laxyy1/diy/deliverables/DIYWOODPLANNER_Alderline_X4/output/DIYWOODPLANNER_Alderline_X4.pdf

DIYWOODPLANNER | ALDERLINE X4 / P1

WORKSHOP COLLECTION / 01

# Alderline X4

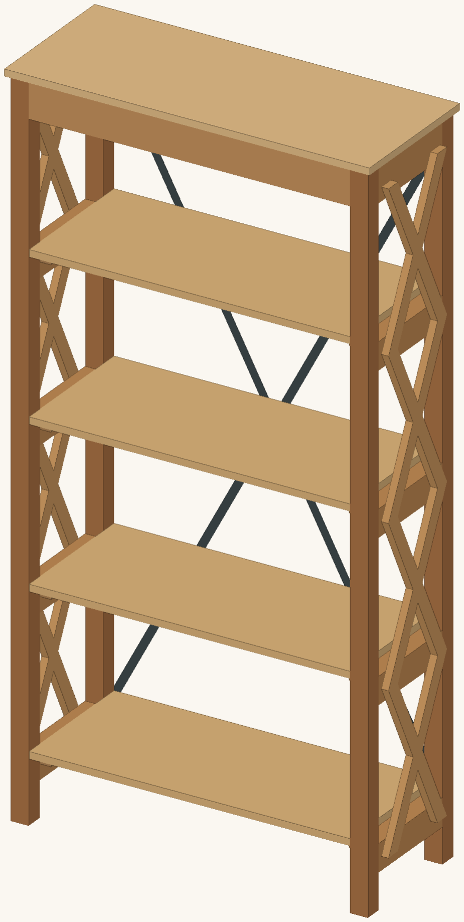
[picture p1: figure]

P1 PROTOTYPE REVIEW • Metric dimensions control • Not a load rating | 01

## FOUR-SHELF X-FRAME BOOKSHELF

Warm timber. Open storage. A measured build.

THE PROJECT

Four shelves + separate
top

936 W × 370 D × 1800 H
mm maximum

Intermediate skill

Dowel joinery + half laps

Two-person final assembly

An original plan inspired by the visible post, shelf and side-X structure in the supplied reference images. Dimensions, connections, rear bracing and page design are newly developed.

BUILD A PROTOTYPE BEFORE RELEASE

Geometry checked; physical performance untested. This plan establishes no safe working load.

01 / DESIGN DEFINITION

# Know the envelope

All dimensions are millimetres. Illustrations are not full-size templates unless specifically identified.

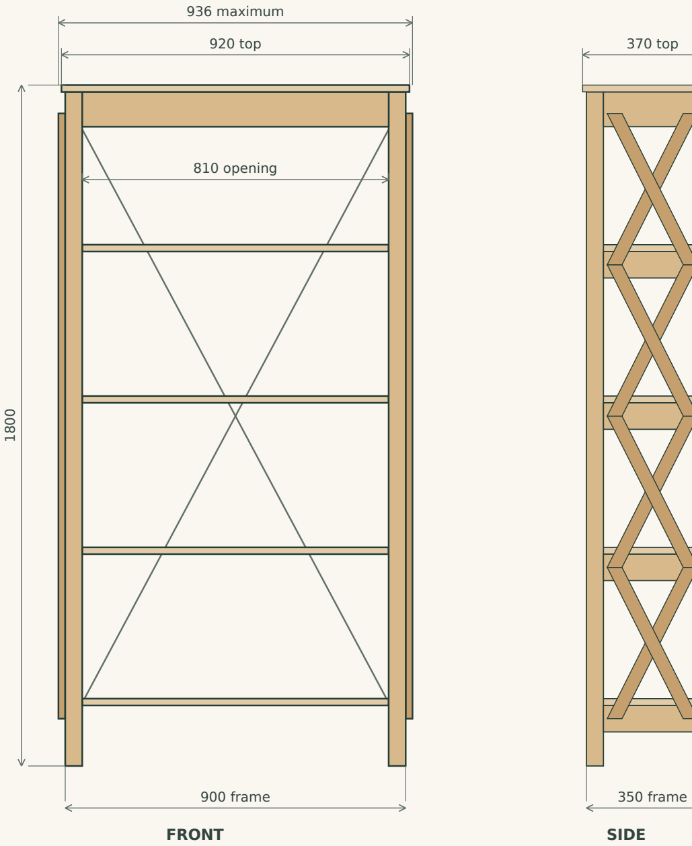
[picture p2: figure]
920 top; 936 maximum; 900 frame; 810 opening; 370 top; 350 frame; FRONT; SIDE
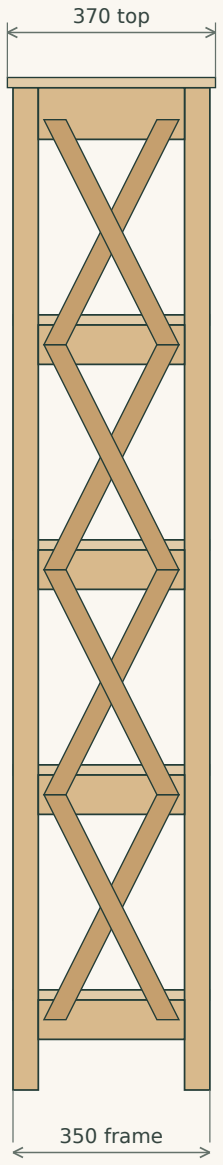
[picture p3: figure]

P1 PROTOTYPE REVIEW • Metric dimensions control • Not a load rating | 02

Maximum width is 936: the side X slats project 18 beyond each frame edge. The top is 920 × 370; the frame is 900 × 350. Nominal height excludes foot pads and wall restraints.

Shelf tops: 178 / 578 / 978 / 1378 above floor. Clear space between shelves: 382. Upper front opening: 312 below apron. Shelf undersides: 160 / 560 / 960 / 1360.

02 / CUTTING & PURCHASING

# Every part, accounted for

Finished sizes: thickness × width × length. Measure actual stock before cutting; nominal lumber names do not control.

P1 PROTOTYPE REVIEW • Metric dimensions control • Not a load rating | 03
ID | PART | QTY | FINISHED SIZE / mm
A | Posts | 4 | 45 × 45 × 1782
B | Shelf side rails | 8 | 45 × 70 × 260
C | Upper side rails | 2 | 45 × 92 × 260
D | Shelf panels | 4 | 18 × 348 × 809
E | Top panel | 1 | 18 × 370 × 920
F | Front/rear top aprons | 2 | 18 × 92 × 810
G | Shelf support cleats | 8 | 30 × 30 × 260
H | X slats | 16 | 18 × 35 × 447.6
J | Rear steel straps | 2 | 1 × 20 × 1864.1

H length 447.6 is measured along either long edge between parallel end cuts. It is not the rough blank length. Prepare sixteen 490 mm blanks; keep eight of each complementary lap hand. J length is a fabrication target; drill to the measured end-hole pitch.

PURCHASE BASIS

4 hardwood blanks 45 × 45 × 2400 for A; 2 boards 45 × at least 92 × 2400 for B/C (rip eight rails to 70); 1 board 30 × 30 × 2400 for G; 4 boards 18 × 35 × 2400 for H. Add defect allowance beyond this minimum.

1 sheet cabinet plywood, 2440 × 1220 × 18, for D/E/F. Require sound void-free bearing edges and verified actual thickness. Use exposed, sanded and sealed edges; no edge band thickness is included.

STOCK & CUTTING ALLOWANCE

Layouts allow 3 mm kerfs and at least 10 mm end trim. Choose straight, dry stock; allow more material for knots and tear-out.

03 / HARDWARE & TOOLS

# Connections with a purpose

Quantities below are installed quantities. Buy spare screws and dowels. Choose compatible heads, pilot sizes and corrosion protection.

P1 PROTOTYPE REVIEW • Metric dimensions control • Not a load rating | 04
ID | HARDWARE | QTY
K1 | Fluted hardwood dowels, 8 x 50 mm | 40
K2 | Fluted hardwood dowels, 6 x 40 mm | 8
K3 | Wood screws, 5 x 60 mm | 24
K4 | Wood screws, 4 x 40 mm | 16
K5 | Wood screws, 4 x 45 mm | 32
K6 | Pan-head wood screws, 5 x 35 mm | 4
K7 | Steel washers, 1 mm thick, 5.5 mm bore | 2
K8 | 25 x 25 x 20 mm steel angle, one hole/wing | 4
K9 | Wood screws, 4 x 16 mm | 8
K10 | Commercial furniture-to-wall restraint kit | 2
K11 | Non-slip foot pads, matching thickness | 4

K8 angles must have one hole in each wing; 2 mm steel thickness is assumed for K9 embed. Verify the actual fitting before purchase. K10 wall and furniture fixings follow the chosen manufacturer; no universal anchor or screw capacity is specified.

JOINT ALLOCATION

B/C to A: K1 + wood adhesive. F to A: K2 + adhesive. G to B: K3, three per cleat. D to G: K4, four per shelf. H to B/C: K5, one at each slat end; glue only the fitted lap. J to A: K6 and K7 at J-2 ends. E to F: K8/K9. K11: one per foot.

PREPARE THE BENCH

Saw with repeatable angle stop; router and depth control; matched dowel jig and brad-point bits; drill stops, countersink, clamps, square, tape, straightedge, stud detector and appropriate steel drilling/deburring tools. Also wood adhesive, abrasives 120/180/220, finish, eye/hearing protection and dust extraction.

04 / LAYOUT & DRILLING

# Make the joints repeatable

Required stock: actual 45 mm posts/rails and 18 mm panels/slats. Re-parameterize and regenerate if your stock differs.

P1 PROTOTYPE REVIEW • Metric dimensions control • Not a load rating | 05

SIDE RAIL JOINT / 8 mm

110 / 140

510 / 540

910 / 940

1310 / 1340

1710 / 1762

APRON JOINT / 6 mm

1710 / 1762

A post side bores: centred 22.5 across the 45 mm face, drilled into the front/rear post faces facing the side rails. A apron bores: 9 from the front or rear outside edge, drilled from the faces facing across the 810 opening.

Label A-LF, A-LR, A-RF, A-RR (left/right and front/rear, viewed from front). Mirror the drilling, not the height datums. Reference every height from the same finished foot end.

BORE SCHEDULE

B: two Ø8 end bores, thickness centre 22.5; 20 and 50 above rail bottom. C: same centre; 20 and 72 above bottom. Drill 26 deep in both rail and post for 25 embed each. F: two Ø6 end bores, 9 through thickness; 20 and 72 above bottom. Drill 21 deep in apron and post for 20 embed each.

Dry-fit one complete joint on scrap first. Use stop collars; clear chips and glue squeeze-out. Target bore centres ±0.25 mm; do not force mismatched dowels or drill through a post.

05 / X-SLAT FABRICATION
One bay. Eight repeated Xs.

H is a flat 18 × 35 slat. Make eight rising and eight falling members with complementary 9 mm laps.

P1 PROTOTYPE REVIEW • Metric dimensions control • Not a load rating | 06

240 overall

400 end-plane spacing

PARALLEL END CUTS / 26.66° OFF SQUARE

Finished length on either long edge: 447.59. End cut projects 39.16 horizontally. Start with 490 blanks; the minimum projected blank length is 465.16. Make a full-size scrap bay jig with end planes 400 apart and outer edges 240 apart. Saw settings are nominal: confirm the jig fit before batch cutting.

LAP SECTION / schematic

9 deep from opposite faces

Mark the true overlap by crossing two slats in the jig. Remove the intersection rhombus, not a square notch. Preserve the 35 mm width.

Centre each lap at the bay centre: y = 175, z = 325 for the first bay. The rhombus is 43.64 along either long edge; its two boundaries run parallel to the mating slat edges. Rout/saw waste in stages to a flat 9.0 depth. Use the 1:1 DXF/SVG outline to verify the marked shape; test print scale before use.

FIT WITHOUT FORCE

Assembled lap thickness must equal 18. Test on scrap; target flush faces within 0.2 mm. Do not thin both members until the joint becomes loose.

06 / ASSEMBLY 1

# Build two side frames

Parts A ×4, B ×8, C ×2. K1 ×40. Assemble on a flat bench with cauls and matched spacers.

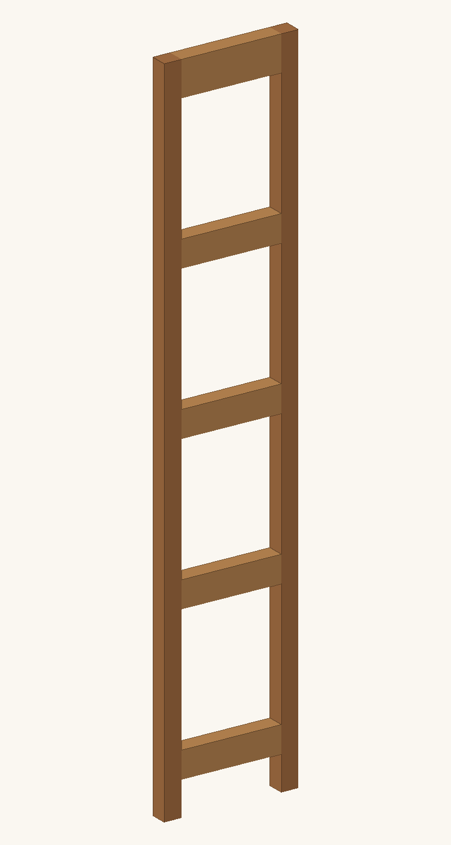
[picture p4: figure]

P1 PROTOTYPE REVIEW • Metric dimensions control • Not a load rating | 07

### 1 Label and dry-fit

Use the post identities from page 5. Rail bottoms are 90, 490, 890 and 1290 above each foot. Upper rail C starts at 1690. Keep all outer side faces flush.

### 2 Glue one side

Spread adhesive on the dowels and bore walls to the adhesive maker’s guidance. Seat B/C between the front and rear posts. Clamp gently across the 350 frame depth; protect the posts with cauls.

### 3 Square before cure

Check the outside post rectangle: 350 wide × 1782 high. Equal opposite diagonals are approximately 1816.0. Check straightness and twist, then recheck all five rail elevations.

### 4 Repeat as a matched pair

Build the second side on the same spacer setup. Match front-to-front post lengths and each rail level. Allow the specified full clamp/cure time before handling.

SIDE FRAME DATUMS: A foot = 0. B bottoms = 90 / 490 / 890 / 1290. B tops = 160 / 560 / 960 / 1360. C = 1690–1782. Rail length = 260 between post faces. Finished side depth = 350.

CHECKPOINT

Both frames must sit flat with matching rail heights. An out-of-square frame is corrected now, before adding X slats.

07 / ASSEMBLY 2

# Add the Xs and shelf cleats

Parts H ×16, G ×8. K5 ×32 and K3 ×24. Outer X slats attach to the side rail faces; cleats attach inside.

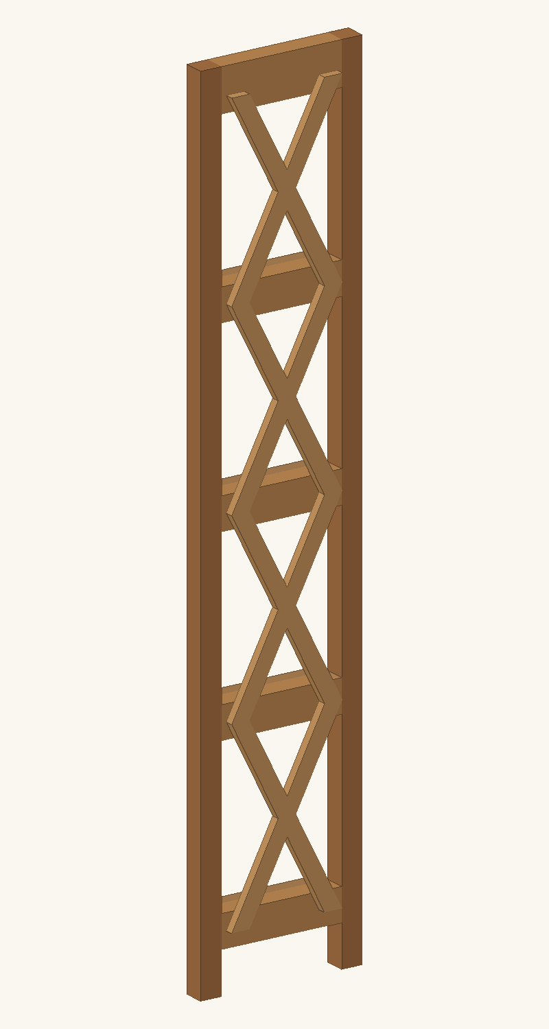
[picture p5: figure]

P1 PROTOTYPE REVIEW • Metric dimensions control • Not a load rating | 08

### 5 Seat the repeated Xs

End planes are 125/525/925/1325/1725 above the feet. Slat outer depth edges are y = 55 and
295. Glue the fitted lap; clamp it flush. Both slats sit directly on the outer rail faces.

### 6 Fasten each slat end

At each end, place one K5 screw on the slat centreline, 20 vertically in from the end plane. In the first rising slat the centres are (y,z) = (84.62,145) and (265.38,505); mirror for the falling slat. Repeat every 400 in height.

### 7 Fix the inner cleats

G tops align with B tops. Left cleats occupy x = 45–75; right = 825–855; both y = 45–305. Drive three K3 through each cleat into B at y = 110/175/240 and 15 below its top.

Drill screw clearance through the attached part and species-appropriate pilots into the receiving timber. Countersink wood heads only to flush; do not bury heads. Clamp before driving. Confirm screw lengths on a scrap joint.

SCREW CLEARANCE MATTERS

Keep the cleat screw positions shown. Moving them to the X end-screw lines can make opposing screws collide inside the rail.

08 / ASSEMBLY 3

# Connect the two sides

Parts F ×2 and K2 ×8. Use a helper and a flat, level surface; protect the finished edges.

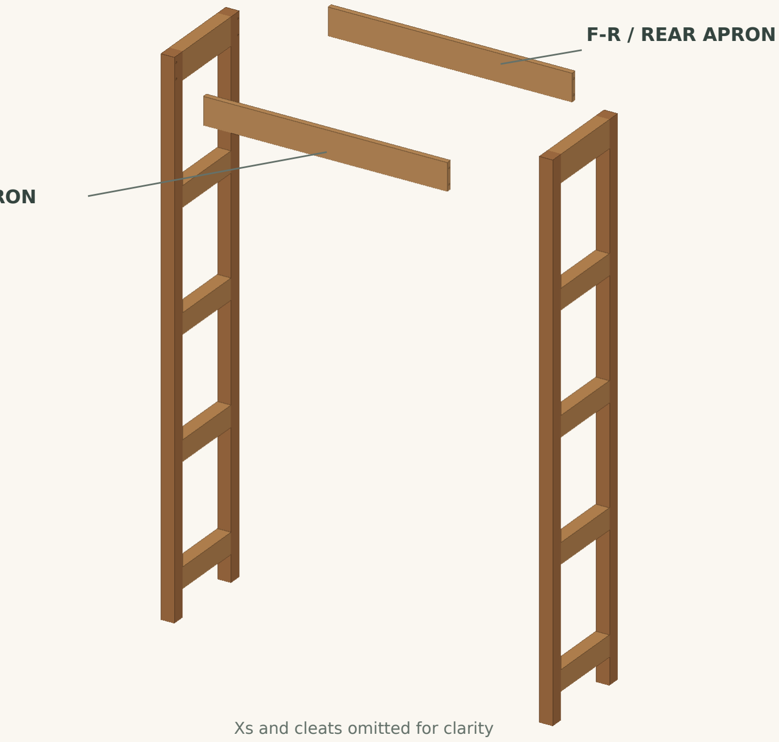
[picture p6: figure]
Xs and cleats omitted for clarity; F-R / REAR APRON

P1 PROTOTYPE REVIEW • Metric dimensions control • Not a load rating | 09

F-F / FRONT APRON

### 8 Dry-fit the full frame

Set the side frames 810 apart between their inner post faces. Fit the front and rear F aprons at z = 1690–1782, with outer faces flush with the front/back post faces. Use 6 × 40 dowels, two per apron end.

### 9 Glue, clamp and verify

Glue F joints and clamp across the width using long cauls. Check 900 frame width and 350 depth, equal diagonals in plan (about 965.7), and a square front elevation. Keep temporary braces/clamps until the rear straps are fitted and the adhesive is cured.

The exploded drawing separates parts for identification; it does not show a stable unsupported construction stage. Do not leave the tall frame standing unattended before bracing and wall restraint installation.

09 / ASSEMBLY 4

# Fit shelves and the top

Parts D ×4, E ×1. K4 ×16; K8 ×4; K9 ×8. Four shelves sit between the side frames; the top caps the posts.

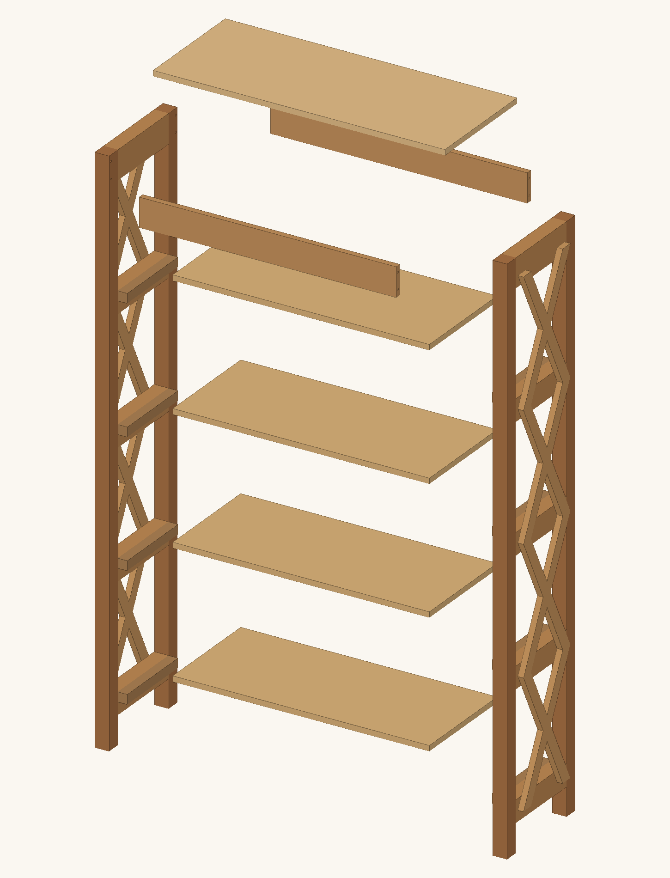
[picture p7: figure]

P1 PROTOTYPE REVIEW • Metric dimensions control • Not a load rating | 10

E / TOP

920 × 370 × 18. Centre for a 10 overhang from each frame edge. It does not overhang the proud X faces.

D / FOUR SHELVES

809 × 348 × 18. Side clearance 0.5 each; front/rear setback 1.0 each. Bearing on each cleat is 29.5 wide × 260 long.

### 10 Screw shelves to their cleats

Install bottom to top. Keep shelf undersides at 160/560/960/1360. Drill K4 clearance through D, pilot G, and countersink flush. Four screws per shelf: x = 60 and 840; y = 90 and 260. Recheck square as each shelf seats.

### 11 Attach the plywood top

Place two K8 angles on the inner face of each F apron, centred x = 250 and 650 from the left frame edge. The horizontal wing meets the underside of E. Use one K9 into F and one into E per angle. Predrill and stop below the show face.

Use the actual angle as the drilling template (about 12 mm hole offset). A 2 mm wing leaves about 14 mm screw embed in 18 mm plywood. Verify screw tips cannot emerge.

10 / ASSEMBLY 5
Brace the back. Anchor the case.

Parts J ×2, K6 ×4, K7 ×2 and two K10 restraint kits. Wall restraints are required before loading.

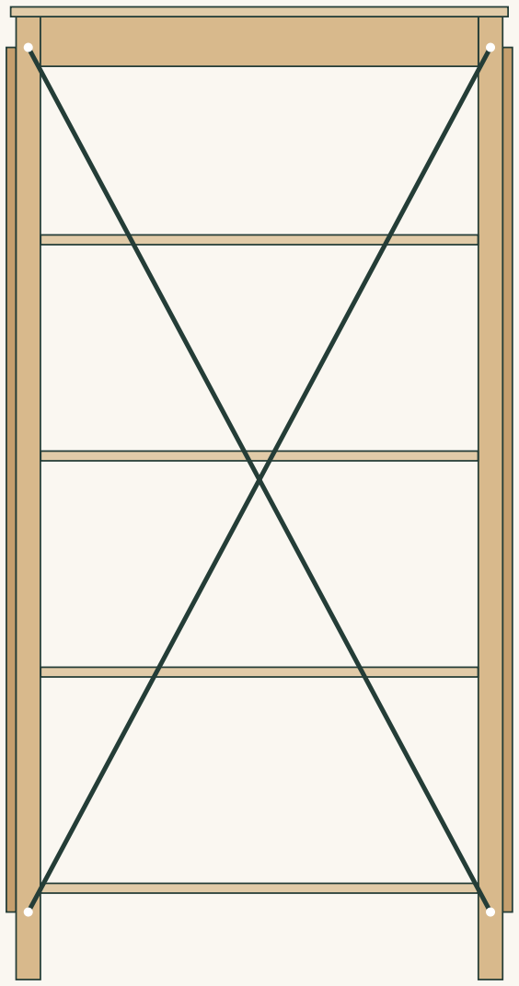
[picture p8: figure]

P1 PROTOTYPE REVIEW • Metric dimensions control • Not a load rating | 11

REAR / straps shown schematically

Fit two commercial 20 × 1 steel cross-straps to rear post centres: x = 22.5 and 877.5. Lower screw level = 125; upper = 1725. Target end-hole pitch is 1814.1; cut length about 1864.1, with 25 beyond each end hole.

Measure the squared case first. Use a timber drilling jig to transfer holes rather than rounding both strap lengths independently. Drill Ø5.5 clearance, deburr and round sharp corners. Do not use steel strapping with unknown brittleness or damaged holes.

Fit J-1 against the post backs. J-2 crosses behind J-1; place a 1 mm K7 washer behind J-2 at each post so its end plane matches the crossing offset. One pan-head K6 per end. Snug both straps with the case square; do not overtighten and bow the frame.

Install two furniture-to-wall restraint kits at the rear posts near z = 1750. Select the complete system for the actual wall and attach to sound structure per its instructions. Check for services before drilling. Keep fittings clear of the C dowels at z = 1710 and 1762; verify the chosen furniture screw path before drilling.

RESTRAINT VERIFICATION

Do not substitute plasterboard alone for a structural fixing. A competent installer must verify the wall, hardware and installation; no fixing capacities are assumed.

11 / FINISHING & HANDOVER

# Bring it into service carefully

Finish adhesion, screw seating and wall restraint installation are separate checks; none is replaced by the CAD model.

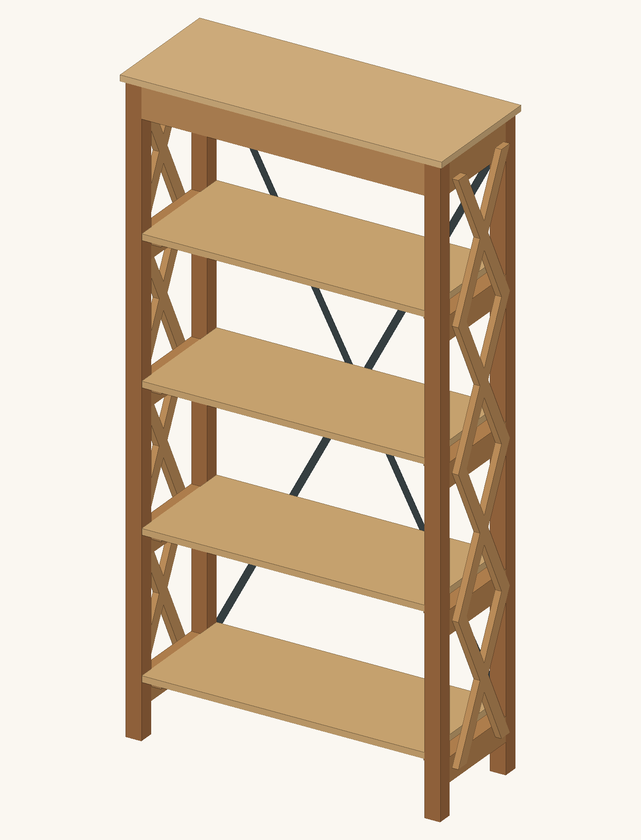
[picture p9: figure]

P1 PROTOTYPE REVIEW • Metric dimensions control • Not a load rating | 12

### 12 Prepare surfaces

After a complete dry-fit, ease accessible edges by about 1 mm. Sand 120 then 180, or to the finish maker’s guidance. Keep dowel holes, lap glue faces and adhesive surfaces free of finish.

### 13 Apply and cure

Pre-finish hard-to-reach areas if useful, then touch up after assembly. Coat exposed plywood edges. Ventilate, manage dust and oily finishing waste, and allow full cure before books contact the surfaces.

### 14 Level and restrain

Fit four equal non-slip pads; shim only with a stable full-bearing solution. Confirm all four feet bear evenly. Install and check both wall restraints before adding contents.

PRE-USE WALKTHROUGH

No rocking, open glue joints, loose laps or split stock.

All shelf edges bear on cleats; no missing or protruding screws.

Back cross-straps are straight and snug; edges are deburred.

Wall connections are checked to the selected kit instructions.

Finish is cured; feet are supported; no climbing or sitting on shelves.

USE & MAINTENANCE

Keep heavier contents low and distribute contents evenly. Recheck joints and restraints after relocation. No safe working load is assigned by this plan.

12 / ENGINEERING & VALIDATION

# What the calculations establish

Computational checks support geometry review. They do not demonstrate strength, stability or suitability for sale.

P1 PROTOTYPE REVIEW • Metric dimensions control • Not a load rating | 13

ILLUSTRATIVE SHELF BENDING

Assume E = 6000 MPa, an 810 mm simply supported span and 348 × 18 gross section. Face grain follows span. Uniform contents mass = 20 kg; assumed plywood density = 650 kg/m³ gives 3.29 kg self-mass. Total gravity force = 228.5 N.

Instantaneous deflection ≈ 1.56 mm | | | Bending stress ≈ 1.23 MPa

I = bt³/12; w = F/L; deflection = 5wL⁴/(384EI); stress = (wL²/8)(t/2)/I. Units: N, mm and MPa. Full-opening span is a conservative bearing idealization; actual cleats support the shelf edges. No allowable stress or deflection acceptance limit has been selected.

E is an assumption, not a verified plywood property. This idealization omits orthotropy, local defects, creep, moisture, duration, impact, connection slip, racking and tipping. No fastener capacities or safe working loads are inferred. The 20 kg scenario is not a load recommendation.

INDEPENDENT CHECKS / 24 OF 24 PASSED

STEP read-back: valid solids and schedule count; dimensional envelope; no positive solid clashes above 0.01 mm³. Reconstructed slat width and lap volume agree. Shelf bearing, clearance, levels, stock nesting, dowel counts, screw tip containment and opposing screw spacing were checked programmatically.

NOT TESTED

No physical assembly, load test, sustained-load test, racking test, tip test or wall-anchor test has been performed. Purchased hardware remains to be selected and verified.

See VALIDATION_REPORT.md and validation.json for the individual checks, equations, measured values, scope and unresolved issues.

13 / RELEASE REVIEW

# Before this plan is sold

P1 is a complete prototype plan package. Commercial release remains subject to the following human and physical checks.

P1 PROTOTYPE REVIEW • Metric dimensions control • Not a load rating | 14

### 1 Build from the manual

An independent woodworker builds one full-size prototype using only this package. Record actual stock thicknesses, tool access, clamp sequence, fit, screw paths and every correction.

### 2 Test the selected materials and joints

Verify species/grade, moisture, plywood quality and stiffness. Evaluate dowel glue joints, cleat fixings, lap fit, rear bracing, screw withdrawal/splitting and purchased bracket suitability using an agreed test protocol.

### 3 Assess strength and stability

A qualified reviewer sets defensible acceptance criteria and tests loading, sustained-load creep, racking, impact and tip resistance with the selected restraint system. Derive any future published load claim from evidence.

### 4 Verify installation and instructions

Trial the wall restraint instructions for the intended wall types. Review entrapment, climbing, sharp edges and hardware hazards for the intended market; obtain applicable product/consumer-safety review.

### 5 Proof the commercial edition

Cross-check all drawings against the prototype, verify 1:1 print scale, review English and hardware availability, and confirm original artwork/text rights and the DIYWOODPLANNER brand authorization.

FILES IN THIS PACKAGE

PDF manual • named STEP assembly and representative part STEP files • SVG orthographic drawings • 1:1 brace profile/lap DXF and SVG • CSV cut/hardware lists • canonical JSON parameters • Python model, renderer, manual and validation sources • machine-readable and written validation report.

A fresh prototype and review are required after dimensional, stock, joinery or hardware changes. Do not edit drawing labels alone; regenerate from the canonical model.

14 / ASSEMBLY ATLAS

# The complete assembly

Exploded view from the same canonical CAD geometry. Separation distances are illustrative, not assembly dimensions.

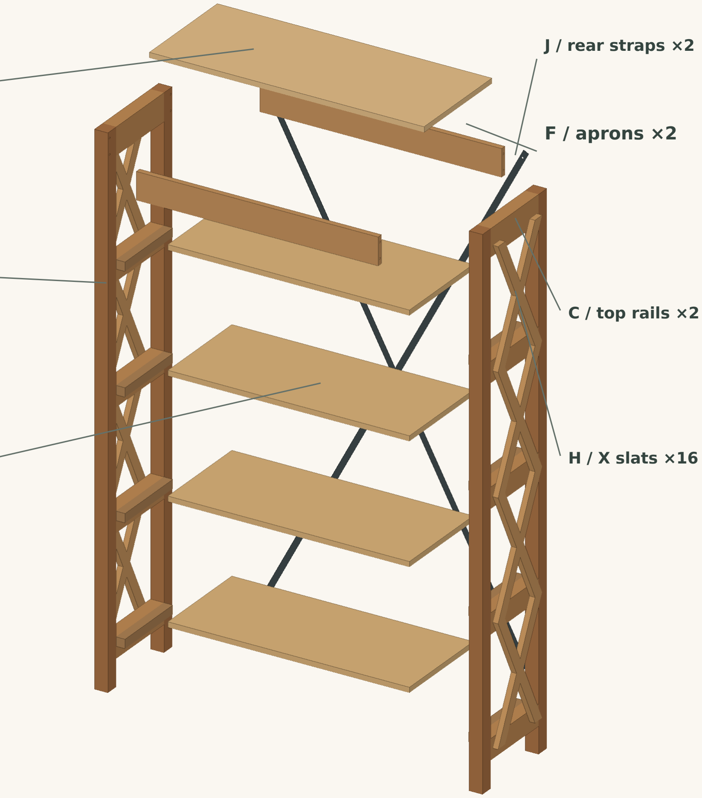
[picture p10: figure]
F / aprons ×2; C / top rails ×2; H / X slats ×16; J / rear straps ×2

P1 PROTOTYPE REVIEW • Metric dimensions control • Not a load rating | 15

E / top ×1

A / posts ×4

D / shelves ×4

SHELF SUPPORT / schematic section

H B

G

D

B is 45 thick. G projects 30 inward, flush to the rail top; D has 0.5 side clearance and 29.5 bearing. The line shows one K3 screw direction. H is shown for orientation on the outer face. Pilot holes and purchased fittings are omitted from the CAD.
