laxyy1/diy/deliverables/DIYWOODPLANNER_Alderline_X4/output/drawings/rear.png

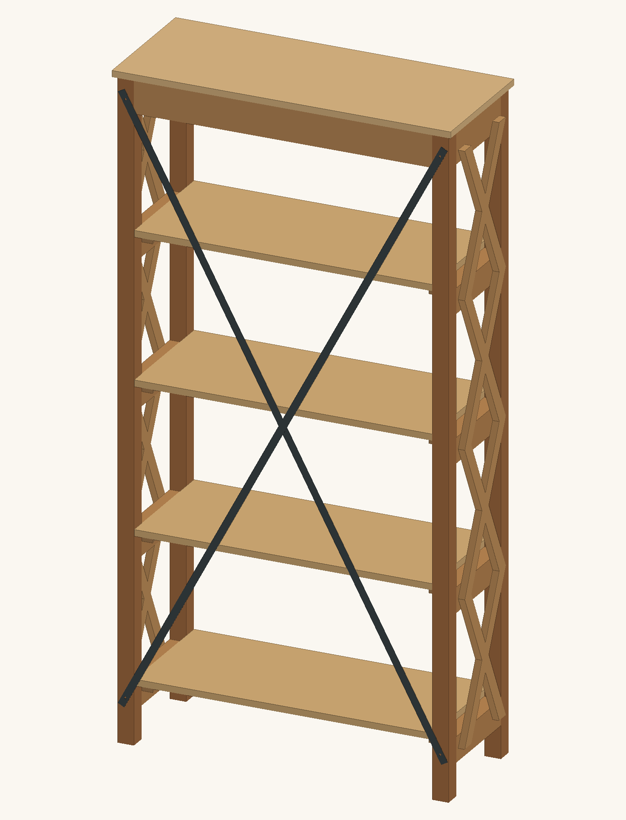
deliverables/DIYWOODPLANNER_Alderline_X4/output/drawings/rear.png
