laxyy1/diy/deliverables/DIYWOODPLANNER_Alderline_X4/output/cad/part_H_b.step

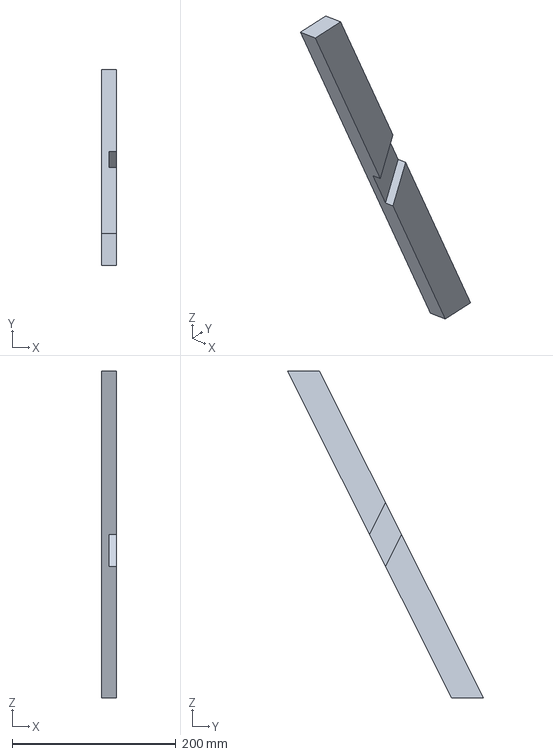
[picture p12: CAD file, 2026-10-22]
deliverables/DIYWOODPLANNER_Alderline_X4/output/cad/part_H_b.step
18.0 x 240.0 x 400.0 mm
