laxyy1/diy/deliverables/DIYWOODPLANNER_Alderline_X4/output/drawings/H_brace_1to1.dxf

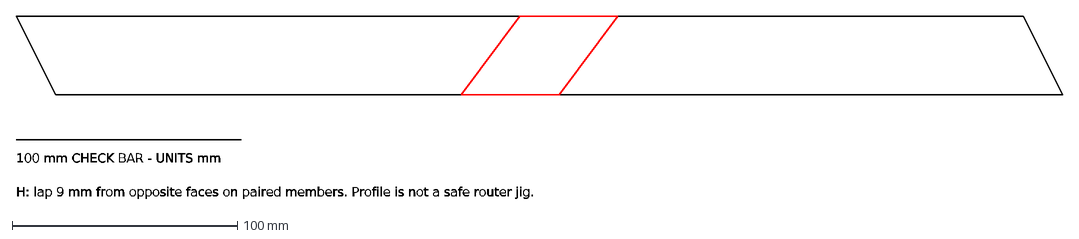
[picture p13: CAD file, 2026-10-22]
deliverables/DIYWOODPLANNER_Alderline_X4/output/drawings/H_brace_1to1.dxf
100 mm CHECK BAR - UNITS mm
H: lap 9 mm from opposite faces on paired members. Profile is not a safe router jig.
