laxyy1/diy/deliverables/DIYWOODPLANNER_Alderline_X4/output/cad/part_F.step

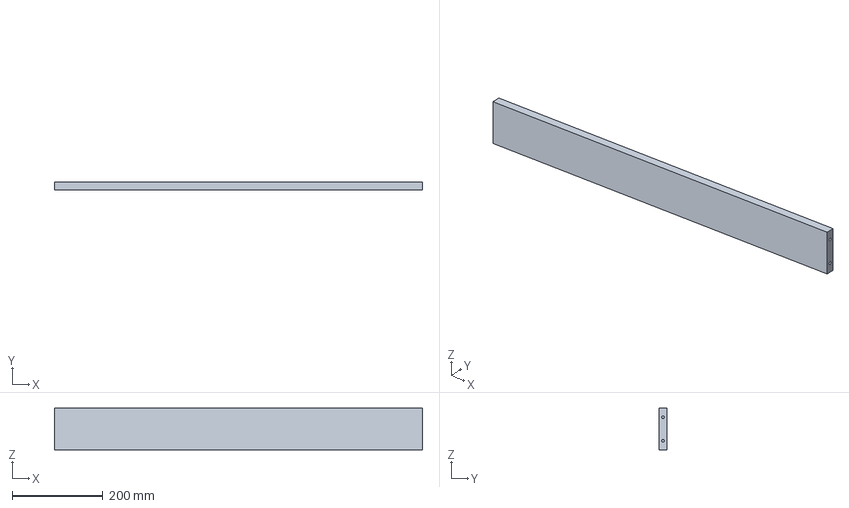
[picture p14: CAD file, 2026-10-22]
deliverables/DIYWOODPLANNER_Alderline_X4/output/cad/part_F.step
810.0 x 18.0 x 92.0 mm
