laxyy1/diy/deliverables/DIYWOODPLANNER_Alderline_X4/output/cad/part_E.step

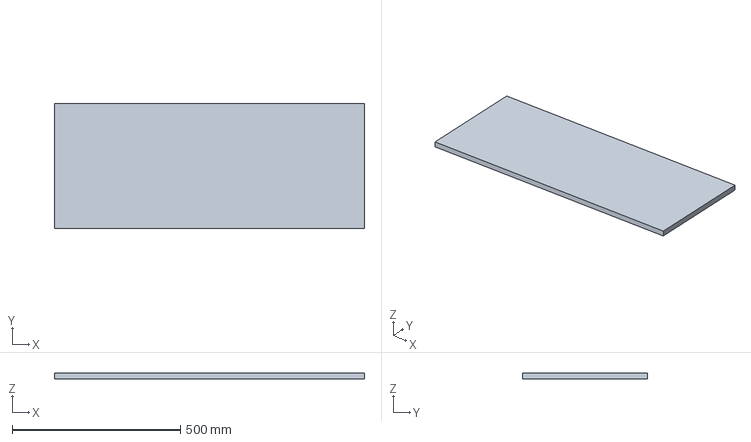
[picture p15: CAD file, 2026-10-22]
deliverables/DIYWOODPLANNER_Alderline_X4/output/cad/part_E.step
920.0 x 370.0 x 18.0 mm
