laxyy1/diy/deliverables/DIYWOODPLANNER_Alderline_X4/output/cad/part_A.step

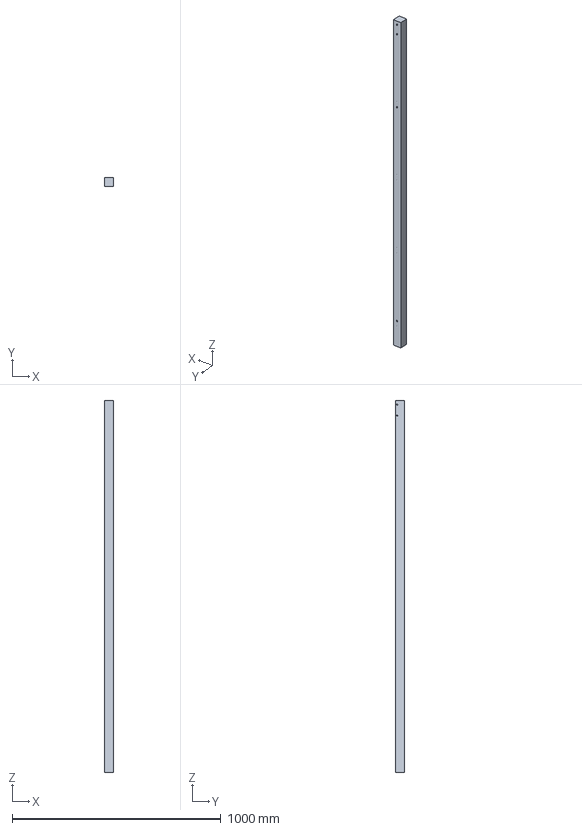
[picture p16: CAD file, 2026-10-22]
deliverables/DIYWOODPLANNER_Alderline_X4/output/cad/part_A.step
45.0 x 45.0 x 1782.0 mm
