laxyy1/diy/deliverables/DIYWOODPLANNER_Alderline_X4/output/cad/part_C.step

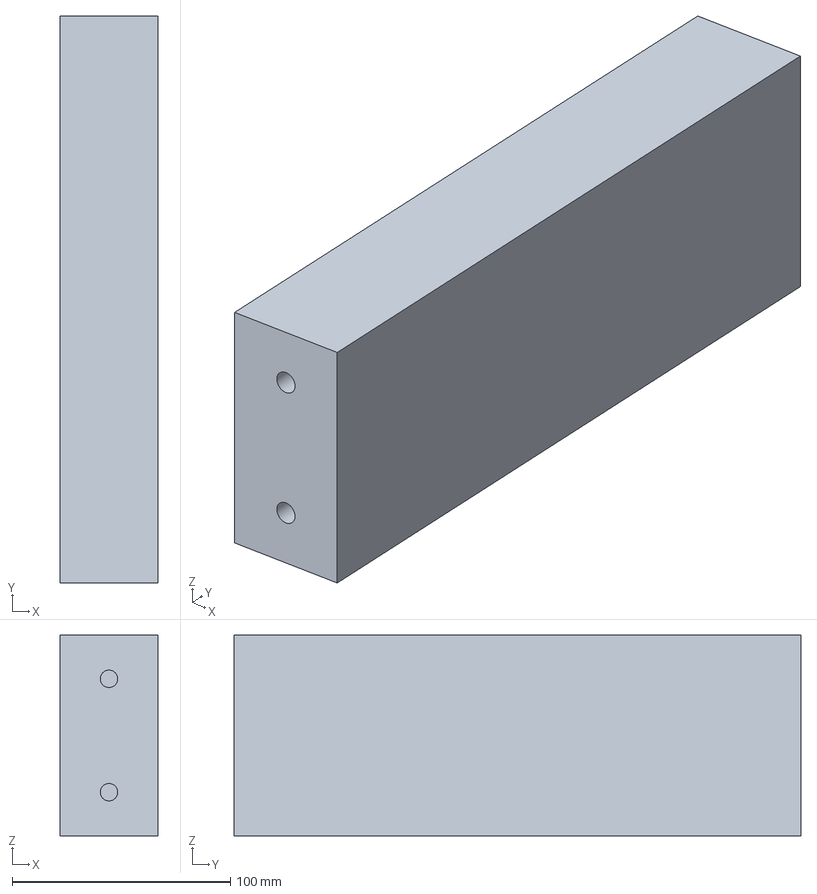
[picture p17: CAD file, 2026-10-22]
deliverables/DIYWOODPLANNER_Alderline_X4/output/cad/part_C.step
45.0 x 260.0 x 92.0 mm
