laxyy1/diy/deliverables/DIYWOODPLANNER_Alderline_X4/output/cad/Alderline_X4.step

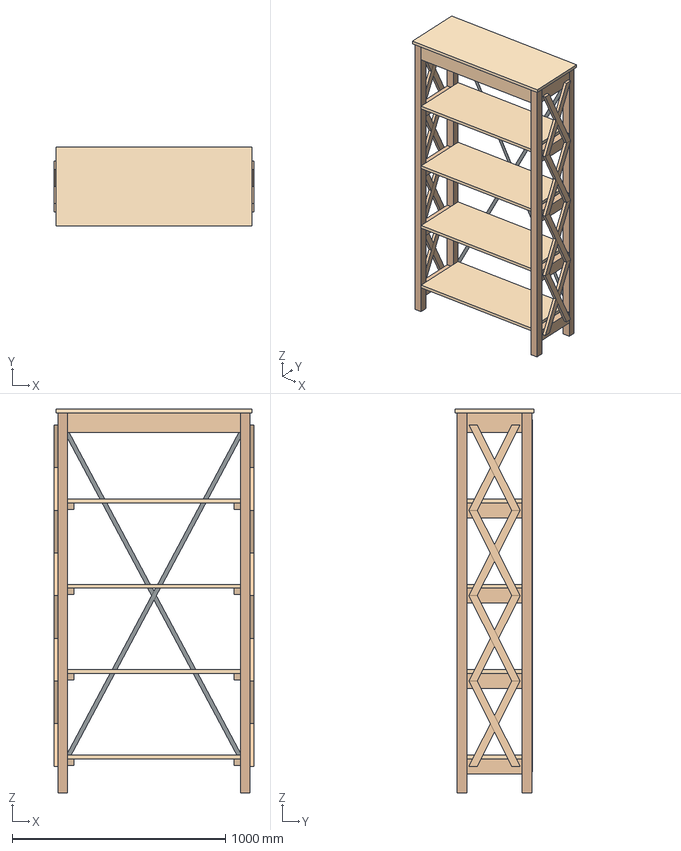
[picture p18: CAD file, 2026-10-22]
deliverables/DIYWOODPLANNER_Alderline_X4/output/cad/Alderline_X4.step
936.0 x 370.0 x 1800.0 mm
A-LF
A-LR
B-L1
B-L2
B-L3
B-L4
C-L5
G-L1
G-L2
G-L3
G-L4
H-L1a
H-L1b
H-L2a
H-L2b
H-L3a
H-L3b
H-L4a
H-L4b
A-RF
A-RR
B-R1
B-R2
B-R3
B-R4
C-R5
G-R1
G-R2
G-R3
G-R4
H-R1a
H-R1b
H-R2a
H-R2b
H-R3a
H-R3b
H-R4a
H-R4b
D-1
D-2
D-3
D-4
E-1
F-F
F-R
J-1
J-2
