laxyy1/diy/deliverables/DIYWOODPLANNER_Alderline_X4/output/cad/part_G.step

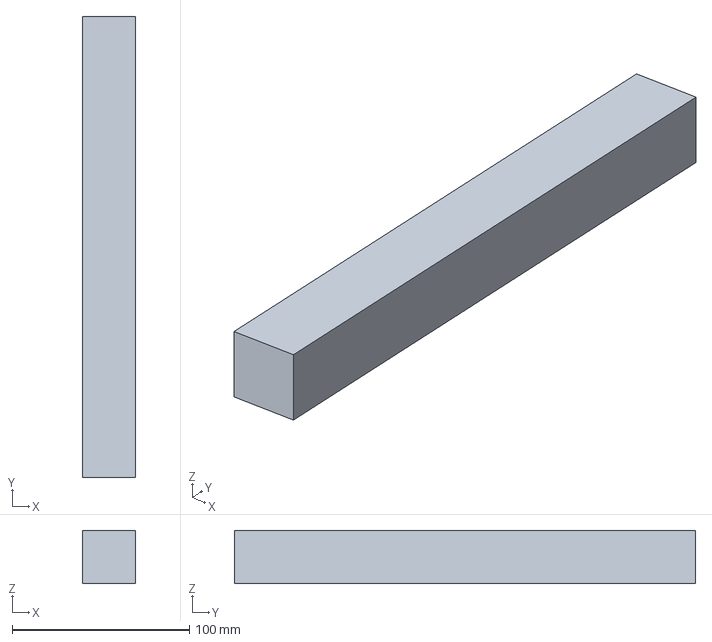
[picture p19: CAD file, 2026-10-22]
deliverables/DIYWOODPLANNER_Alderline_X4/output/cad/part_G.step
30.0 x 260.0 x 30.0 mm
