laxyy1/diy/deliverables/DIYWOODPLANNER_Alderline_X4/output/cad/part_B.step

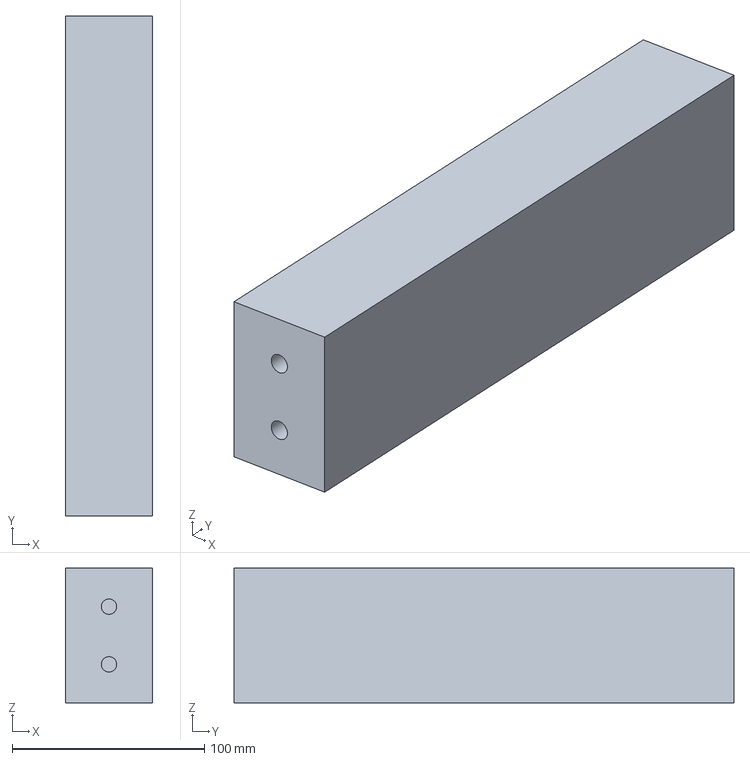
[picture p20: CAD file, 2026-10-22]
deliverables/DIYWOODPLANNER_Alderline_X4/output/cad/part_B.step
45.0 x 260.0 x 70.0 mm
