laxyy1/diy/deliverables/DIYWOODPLANNER_Alderline_X4/output/cad/part_D.step

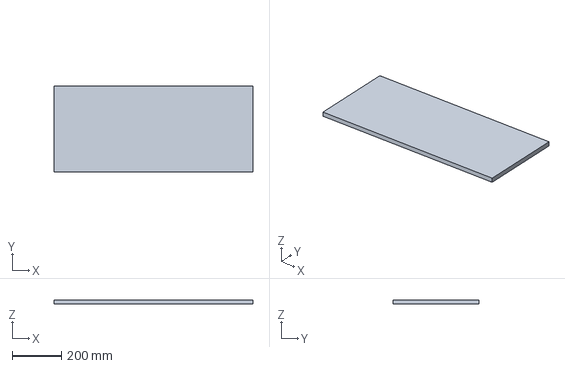
[picture p21: CAD file, 2026-10-22]
deliverables/DIYWOODPLANNER_Alderline_X4/output/cad/part_D.step
809.0 x 348.0 x 18.0 mm
