laxyy1/diy/(list of files, cad)

Other CAD files:
deliverables/DIYWOODPLANNER_Alderline_X4/output/cad/part_H.step
deliverables/DIYWOODPLANNER_Alderline_X4/output/cad/part_H_a.step
