laxyy1/diy/deliverables/DIYWOODPLANNER_Alderline_X4/output/qa/contact_sheet.png

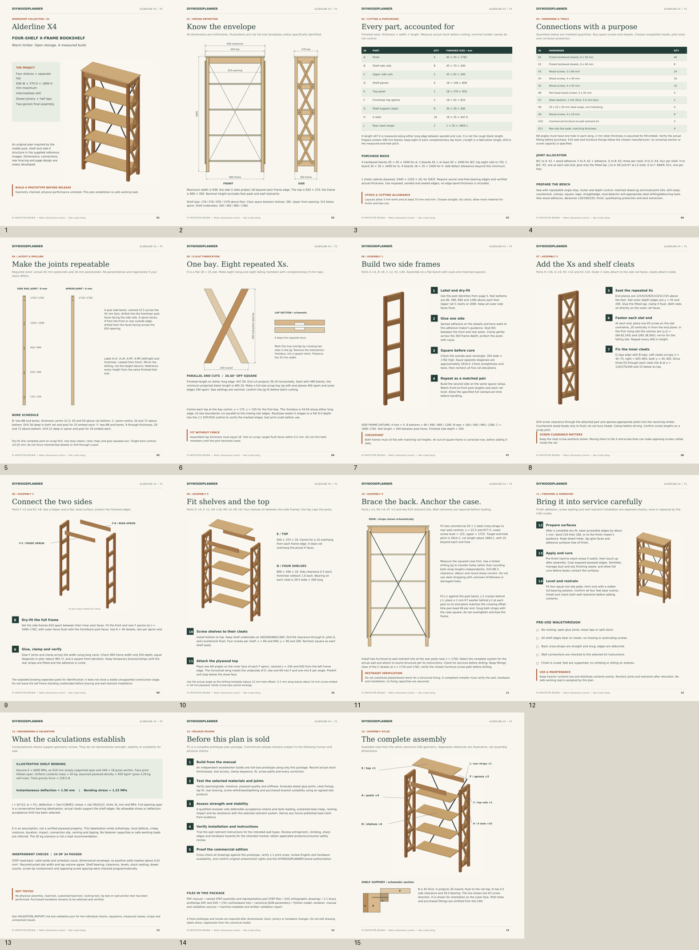
deliverables/DIYWOODPLANNER_Alderline_X4/output/qa/contact_sheet.png
