laxyy1/diy/deliverables/DIYWOODPLANNER_Alderline_X4/output/qa/page_14.png

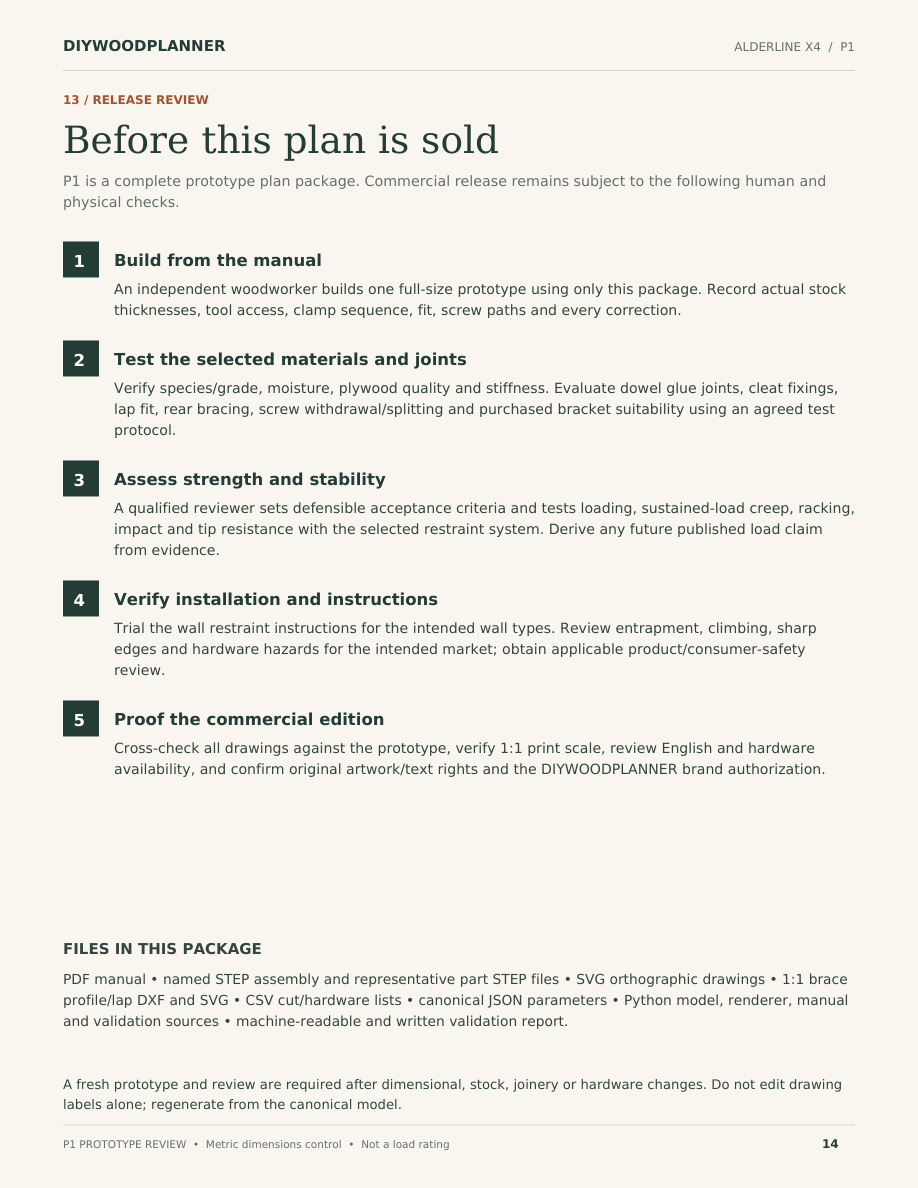
deliverables/DIYWOODPLANNER_Alderline_X4/output/qa/page_14.png
